williamtien23/monkeyV/doc/documentation.md

# riscv32i_w1
 <strong> Contents </strong> <br>
<ol>
  <li> Schematics </li>  
  <li> Compliance Tests </li>
  <li> The ALU Test </li>
  <li> The Sample C Program Test </li>
</ol>

<strong> Schematics </strong> <br><br>
IF_Stage: <br>
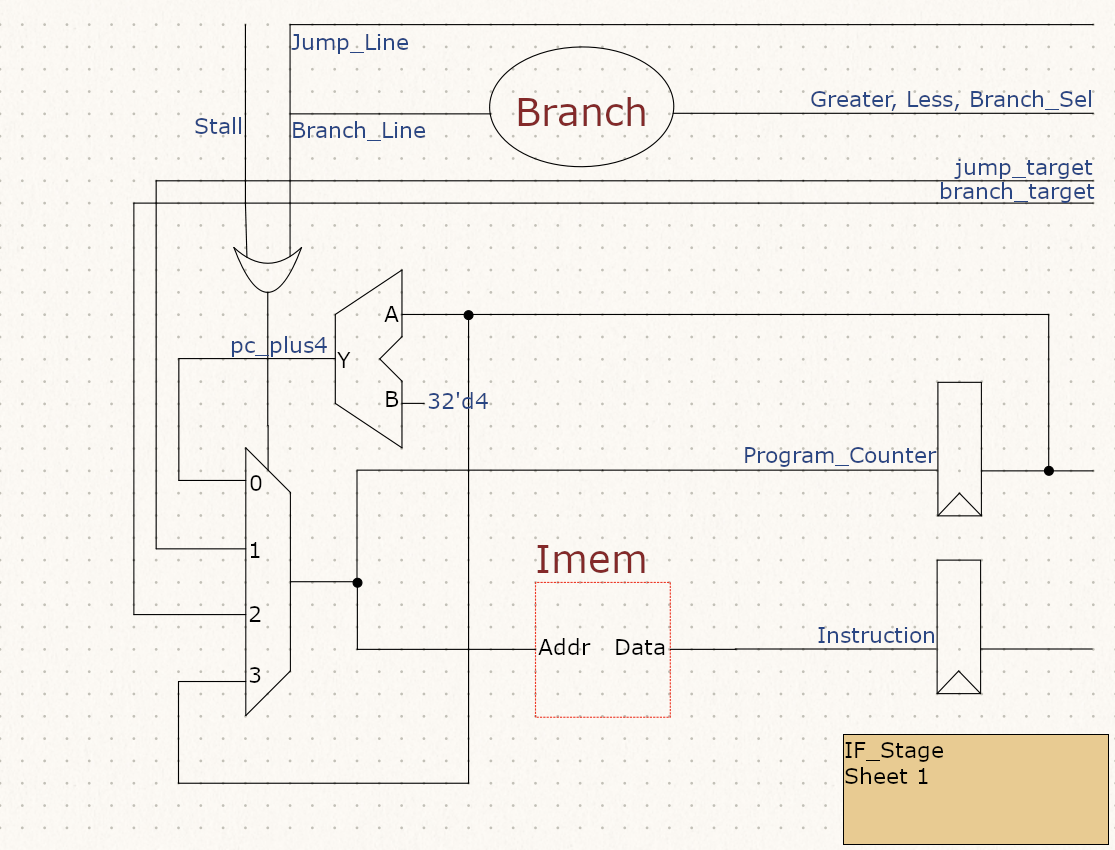
[picture p2: doc/IFStage.png]

<br><br><br>
ID_Stage: <br>
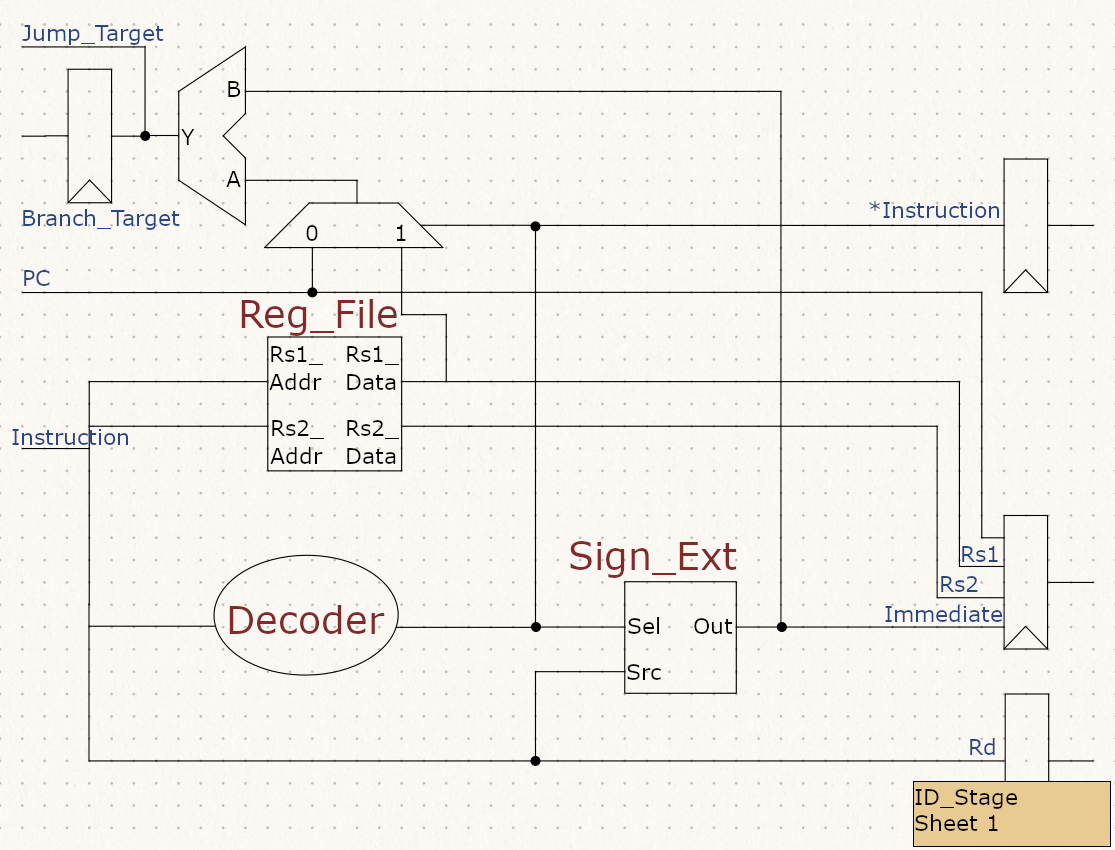
[picture p3: doc/ID_Stage.png]

<br><br><br>
EXE_Stage: <br>
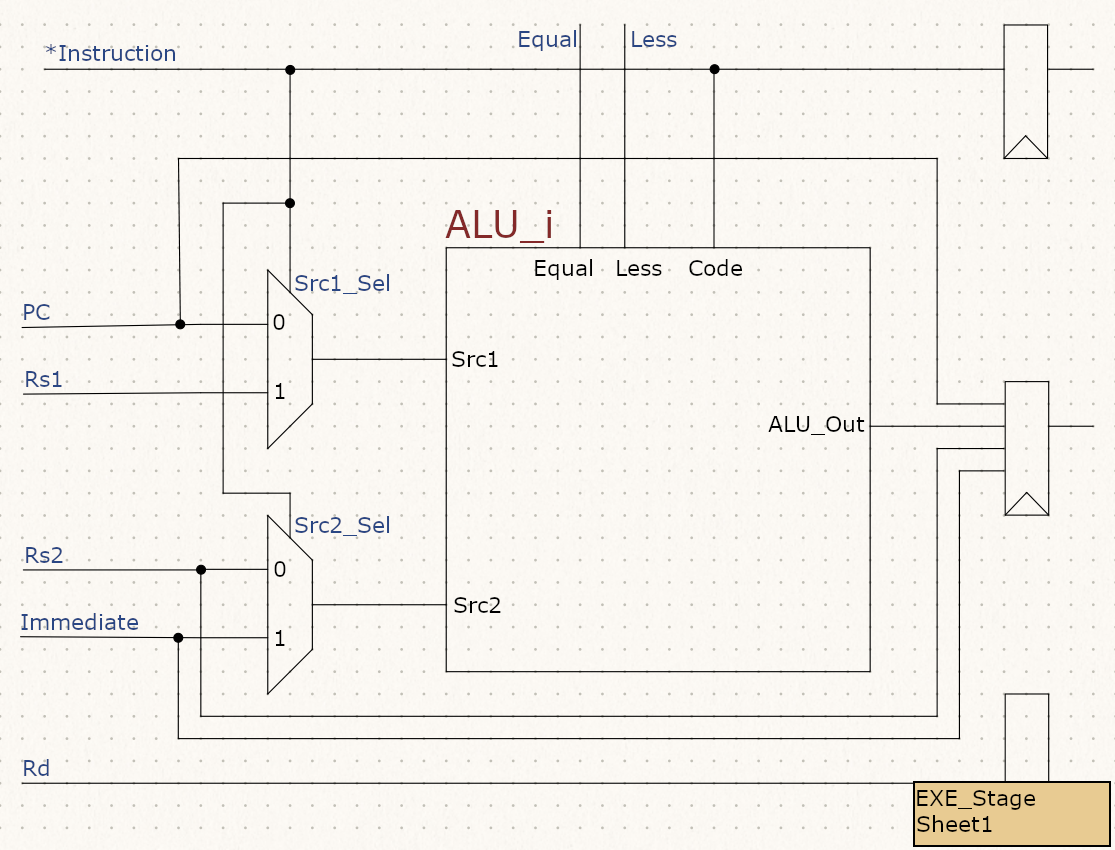
[picture p4: doc/ExeStage.png]

<br><br><br>
MEM_Stage: <br>
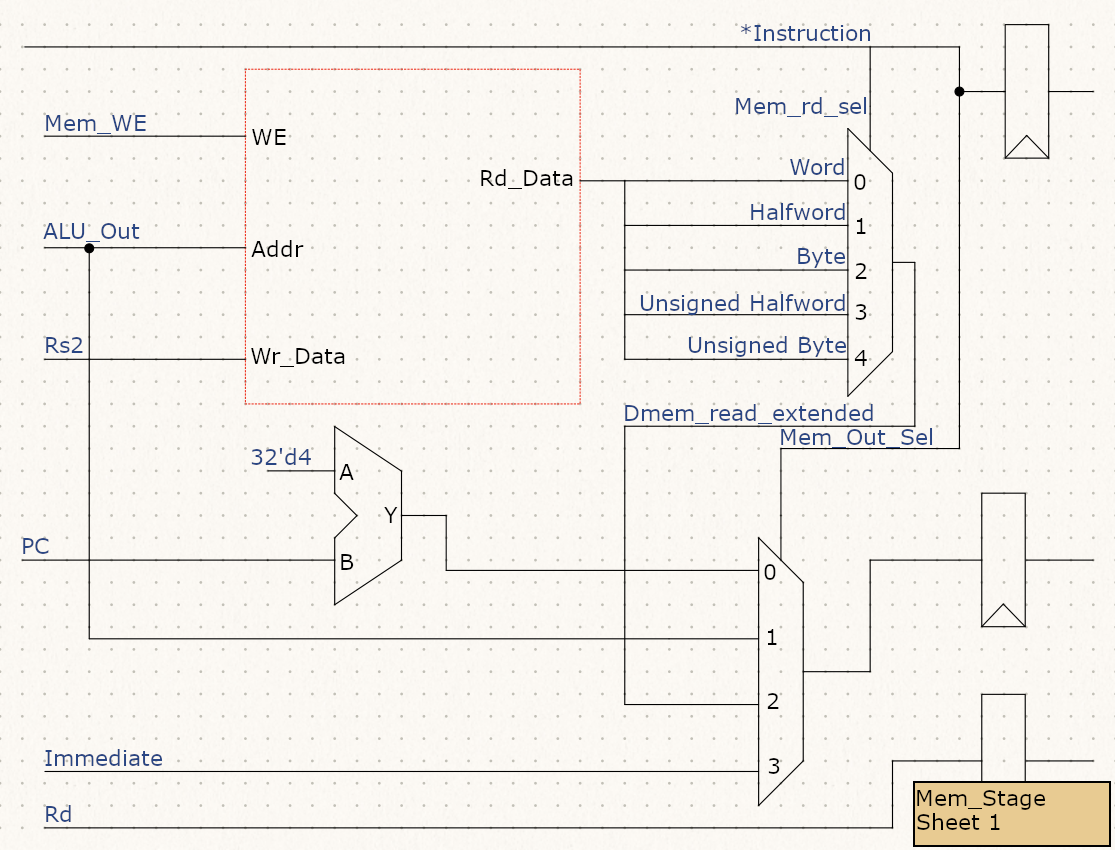
[picture p5: doc/MemStage.png]

<br><br><br>
ALU_i: <br>
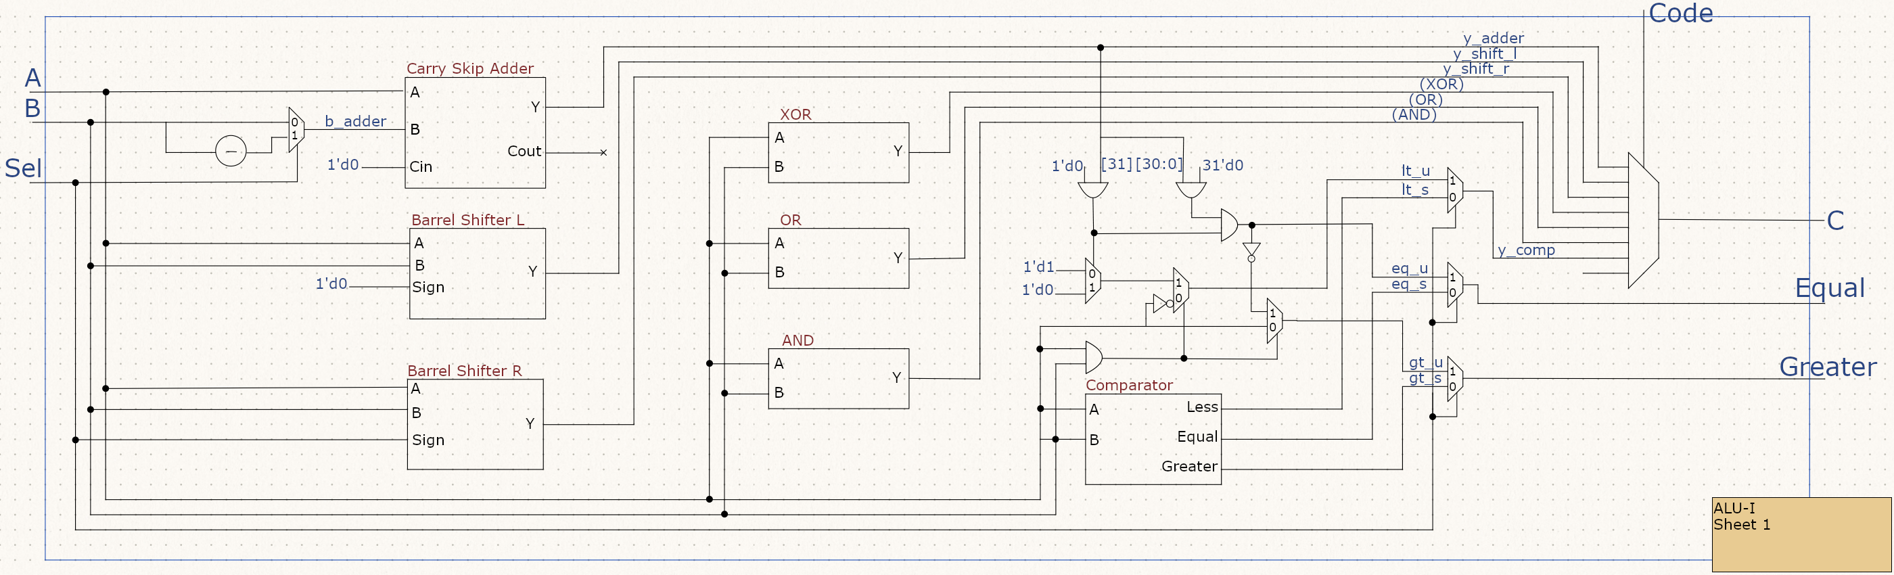
[picture p6: doc/ALU-I.png]

<br><br><br>
Carry_Select_Adder: <br>
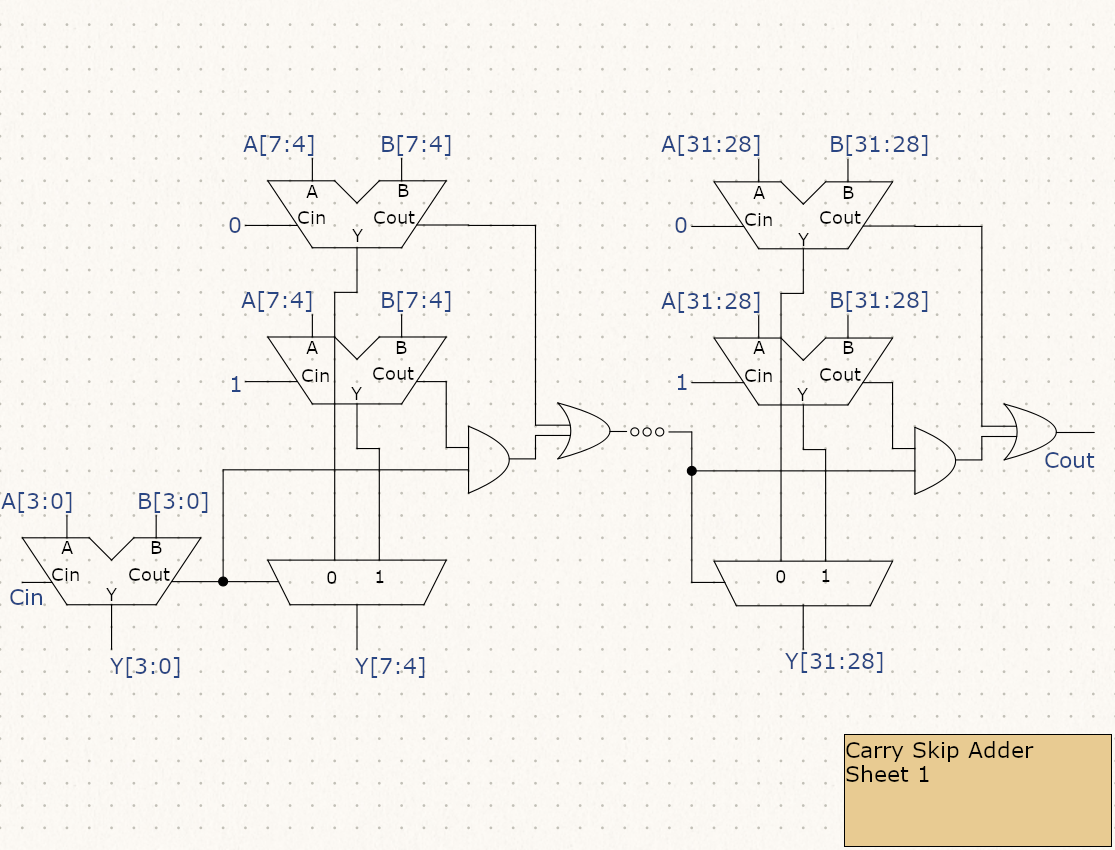
[picture p7: doc/CarrySelect_Adder.png]

<br><br><br>
Barrel_Shifters: <br>
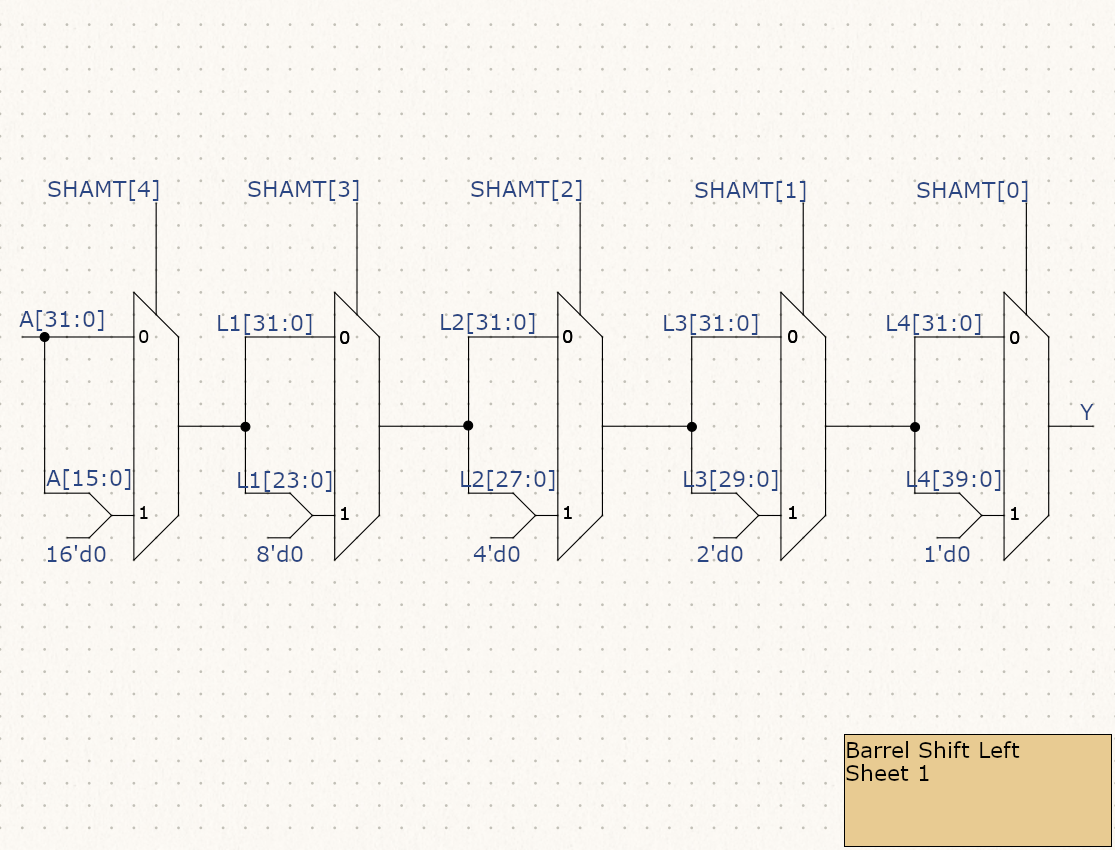
[picture p8: doc/BarrelShifter_Left.png]

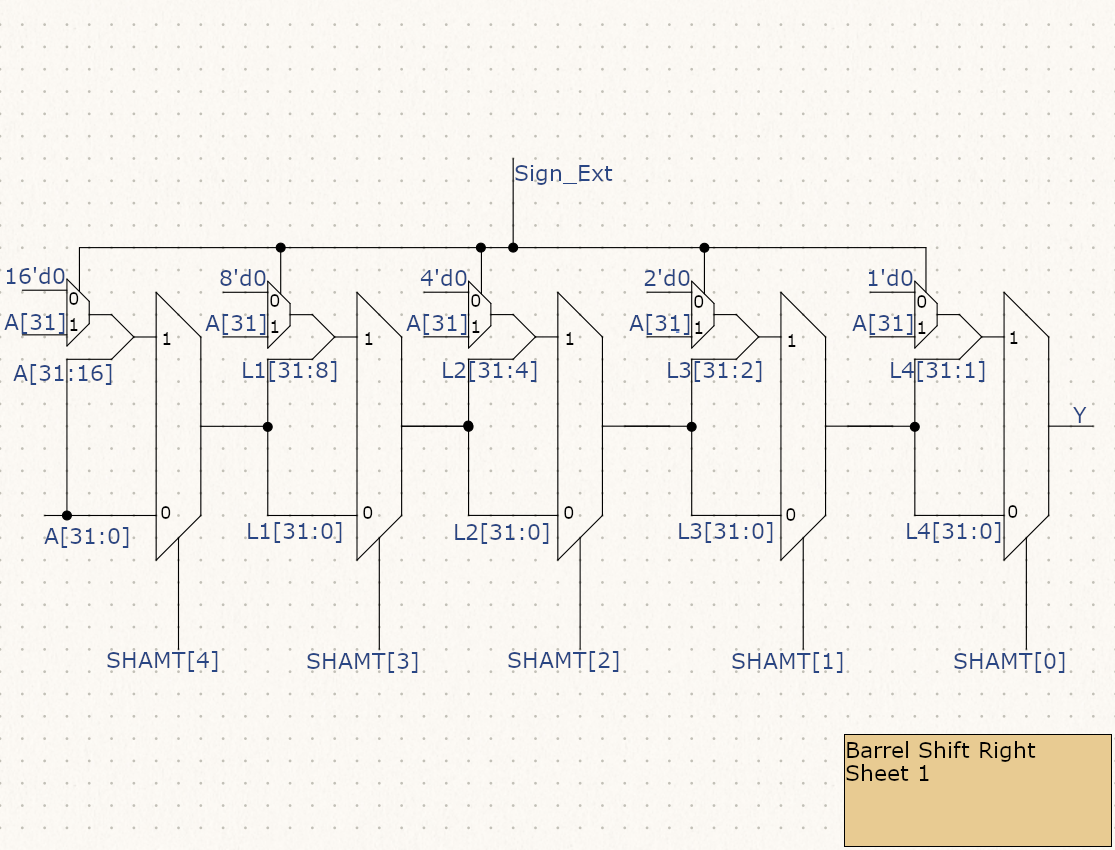
[picture p9: doc/BarrelShifter_Right.png]

<br><br><br>
Digital Comparator: <br>
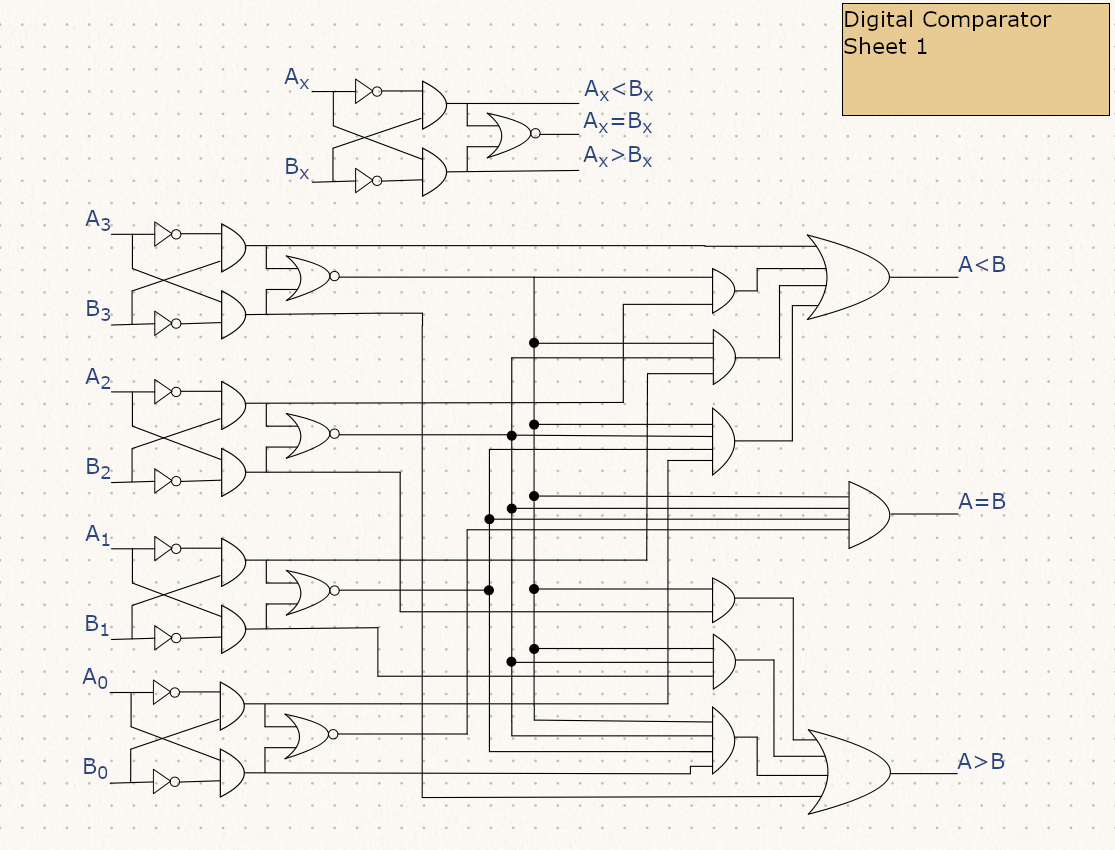
[picture p10: doc/Comparator_Sheet1.png]

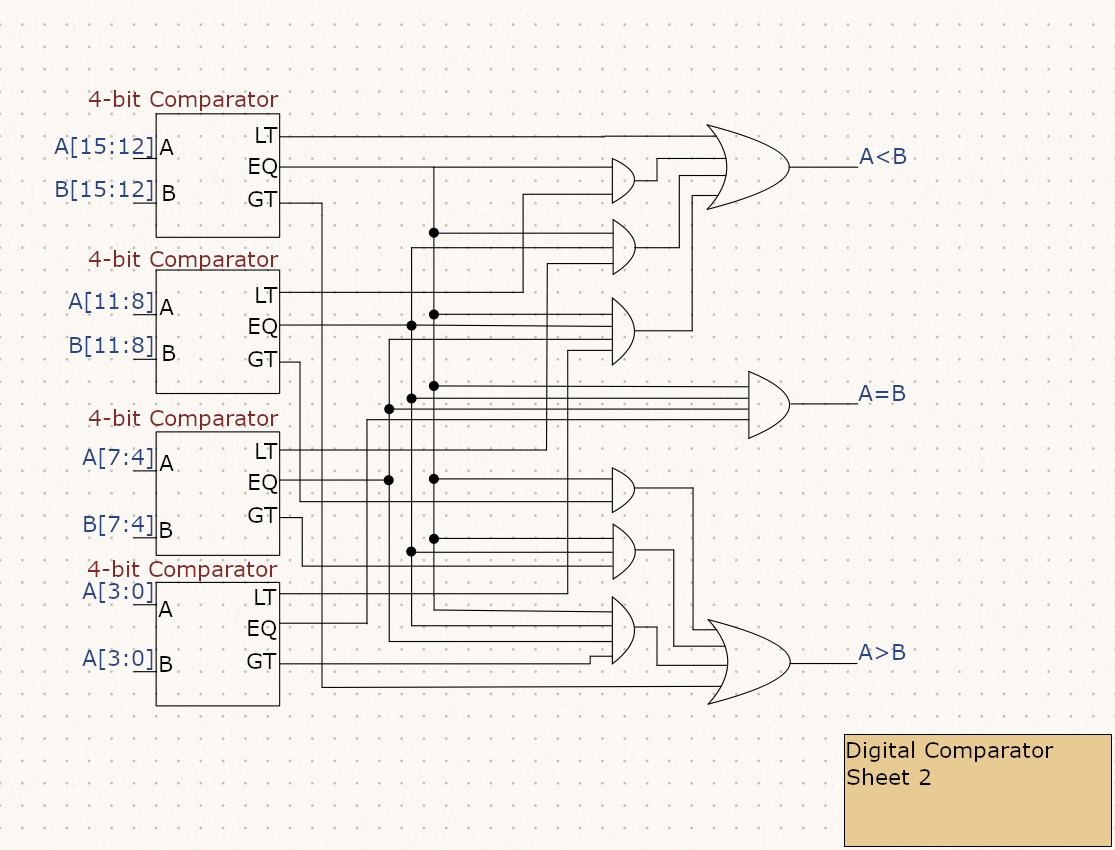
[picture p11: doc/Comparator_Sheet2.png]

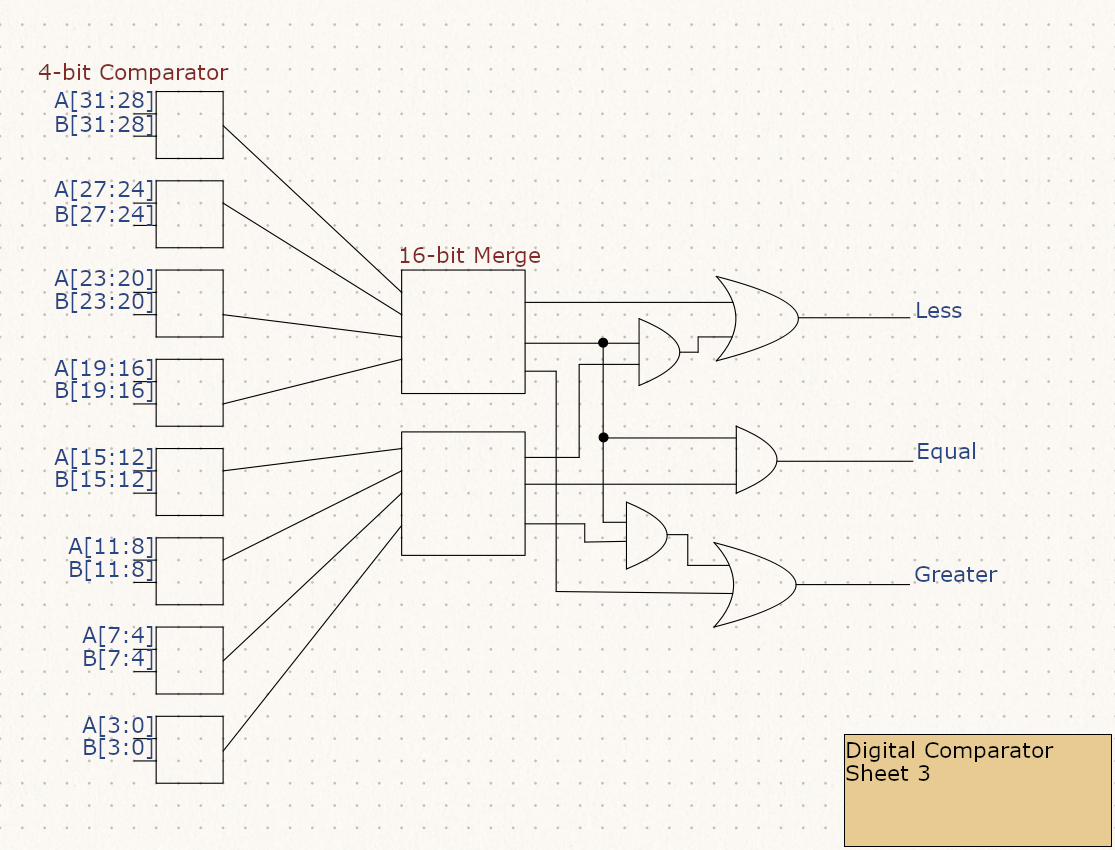
[picture p12: doc/Comparator_Sheet3.png]

<br><br><br>
Sign_Extender: <br>
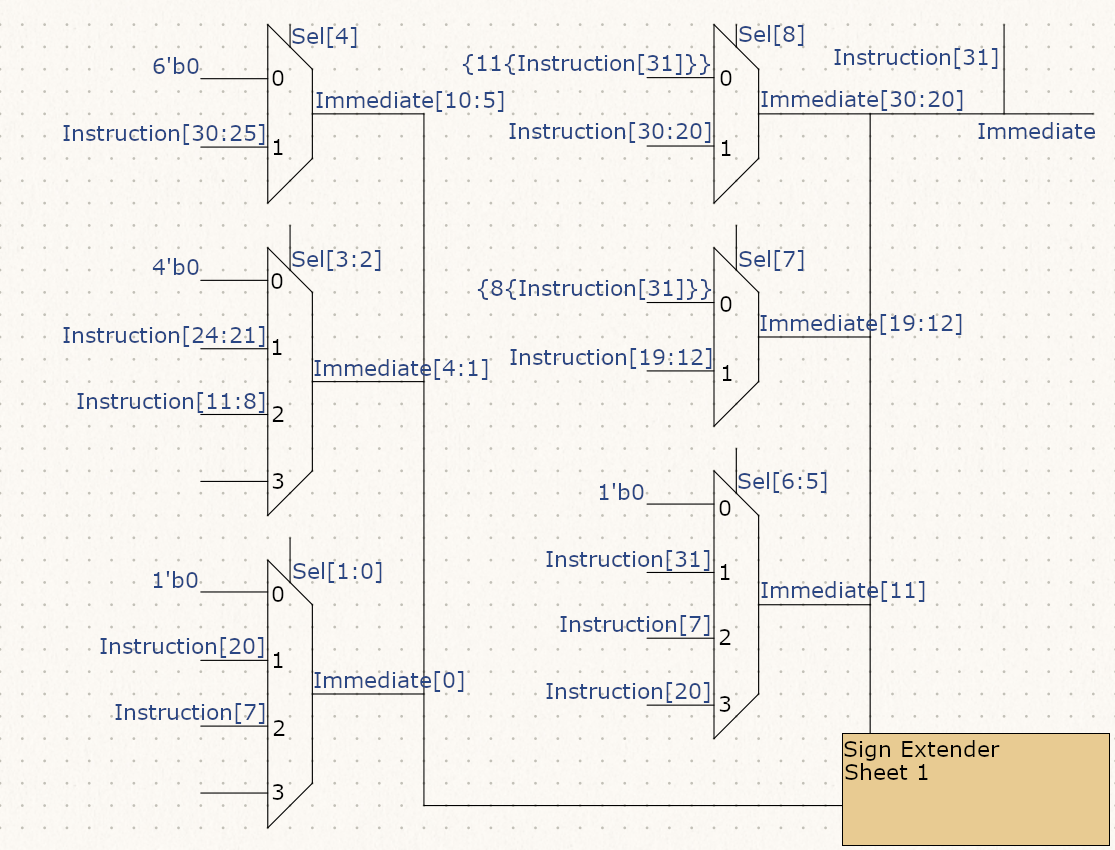
[picture p13: doc/SignExt.png]

<br><br><br>

<strong> Compliance Tests </strong> <br>
Running the automation bash script for the compliance tests generates the following results.
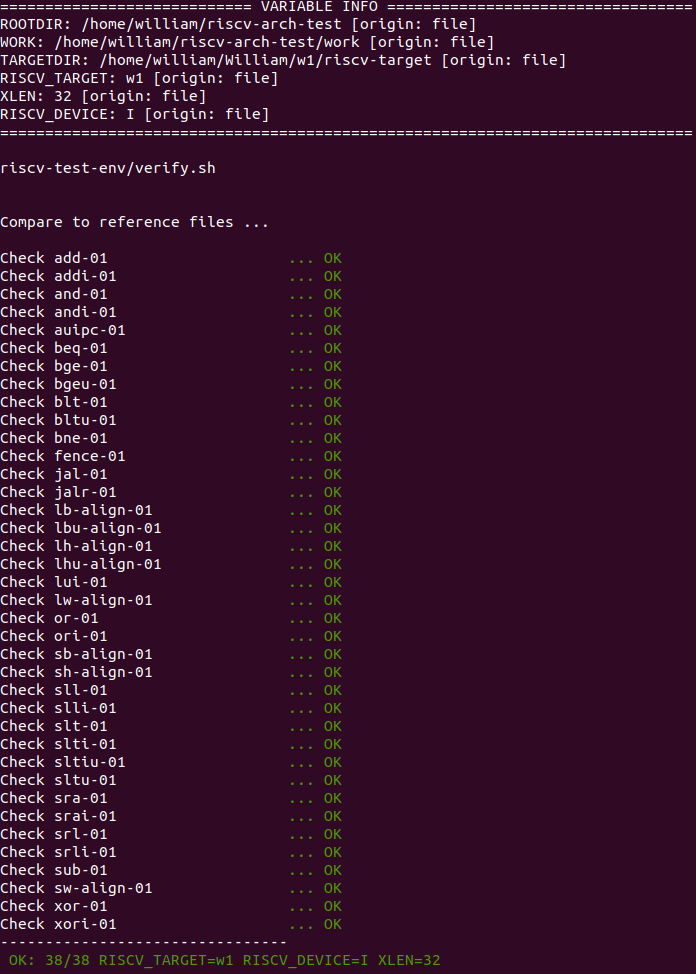
[picture p14: doc/compliance.png]


<strong> The ALU Test </strong> <br>
I tested the ALU by generating random signed int values in the cpp wrapper module. The cpp wrapper performs the same ALU operations alongside the simulated verilog ALU. Both answers are compared and the result is written as a Pass or Fail to the alu_tests.txt file that generates in /Testbenches. If a test case fails, the mismatched result from the verilog ALU is also outputted. An example:<br>
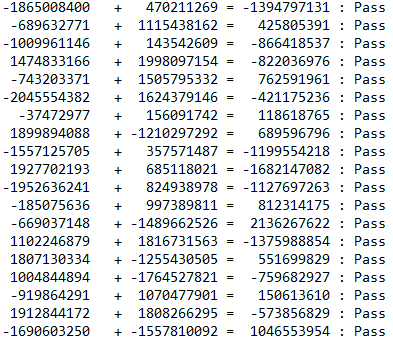
[picture p15: doc/alu_test_example.PNG]

<br>

<strong> The Sample C Program Test</strong> <br>
The following is the .text section of the ELF objdump from the example C program. Below are screenshots of the waveforms generated by running the C program on the core:<br>
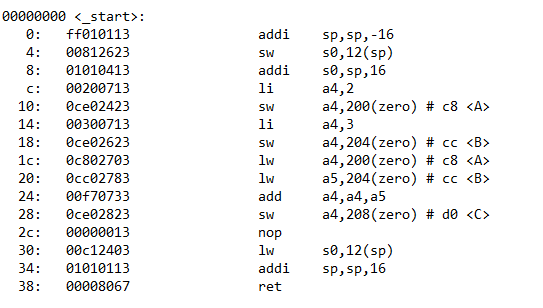
[picture p16: doc/objdump.PNG]

<br>

Program entry and first hazard:
<ol>
  <li> After reset, instruction fetch stage is fetches the first instruction "ff010113" which is latched and evaluated by instruction decode stage in the following cycle. </li>  
  <li> Data dependency on the sp register (x2) between the first instruction and the second instruction. The core stalls. </li>
  <li> Instruction decode stage can proceed only after the dependency has cleared the writeback stage. </li>
</ol>
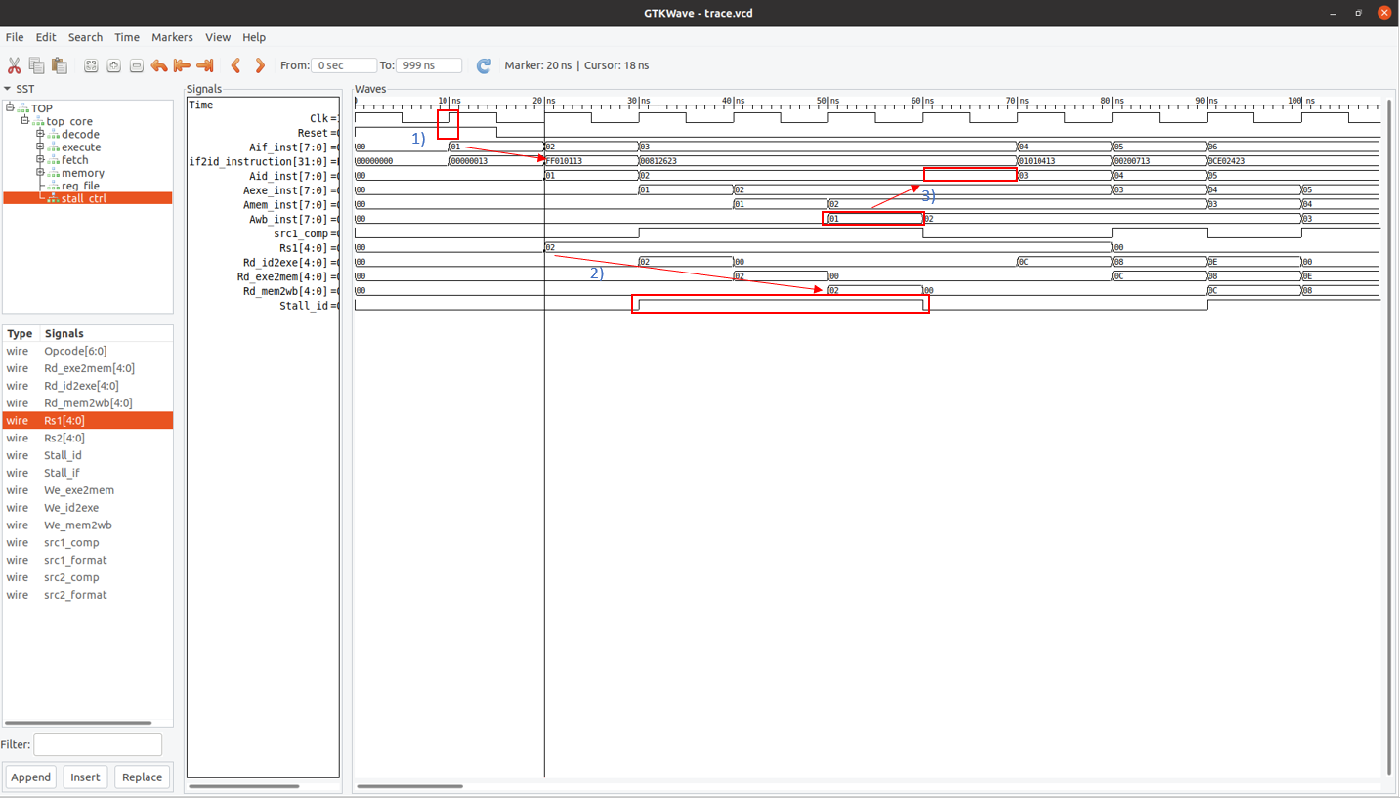
[picture p17: doc/sample_program_hazard.PNG]

<br>

A store instruction and hazard:
<ol>
  <li> Instruction fetch stage is fetching instruction 4 (PC at 0x8) followed by instruction 5 (PC at 0xC). </li>  
  <li> Instruction 5 has a dependency on instruction 4 over the a4 (x14) register. Instruction 4 must commit to write back stage before instruction 5 can proceed in the decode stage in the following cycle. Instruction 5 propogates 2 more cycles into the memory stage, and the correct memory address and write data appears in that cycle. </li>
</ol>
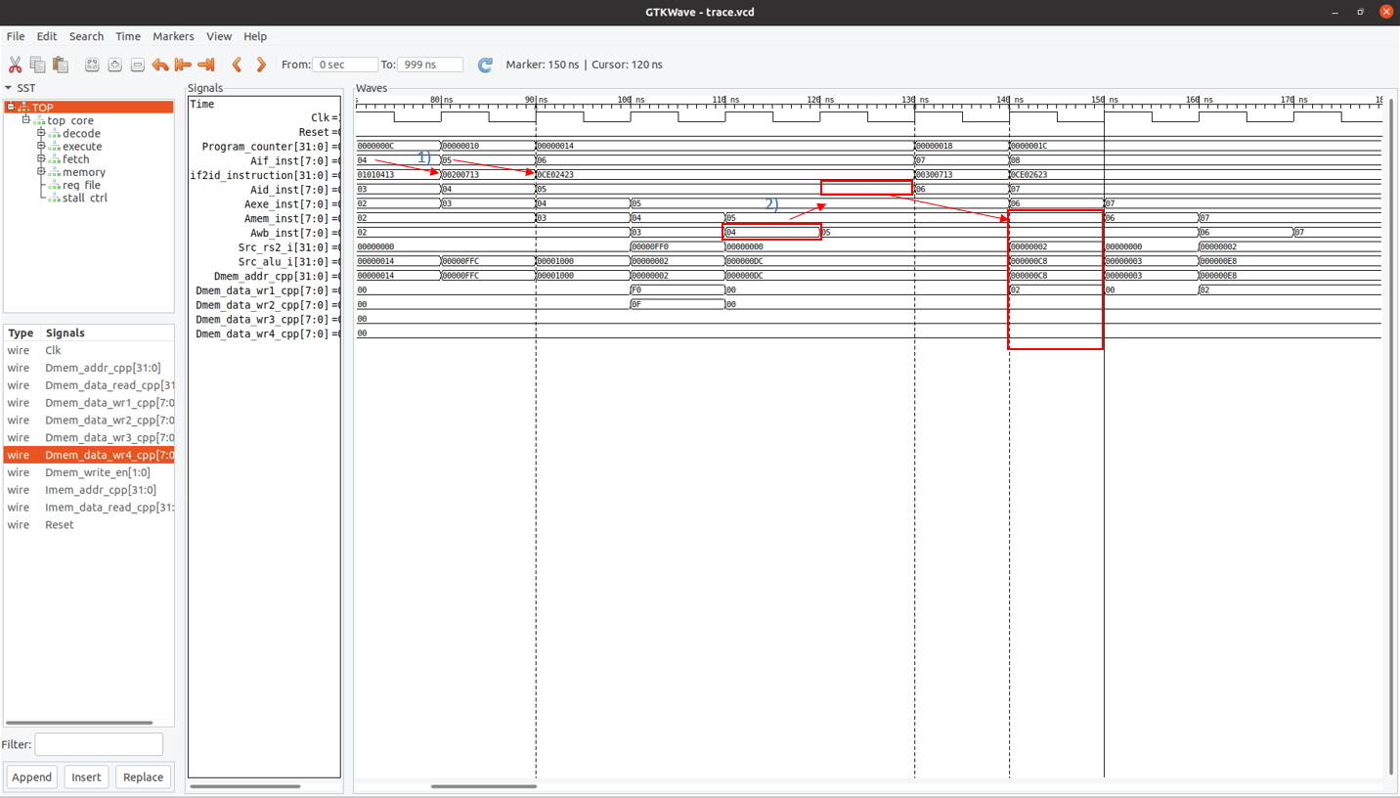
[picture p18: doc/sample_program_sw.PNG]

<br>

A load instruction:
<ol>
  <li> Load instruction "0CC02783" (PC at 0x20) is fetched and decoded. </li>  
  <li> Mem stage sets the correct Dmem address and the "memory" responds in same cycle with the result. </li>
  <li> Result loaded from memory is commited in the writeback stage and can be seen updated in the destination register in the following cycle. </li>
</ol>
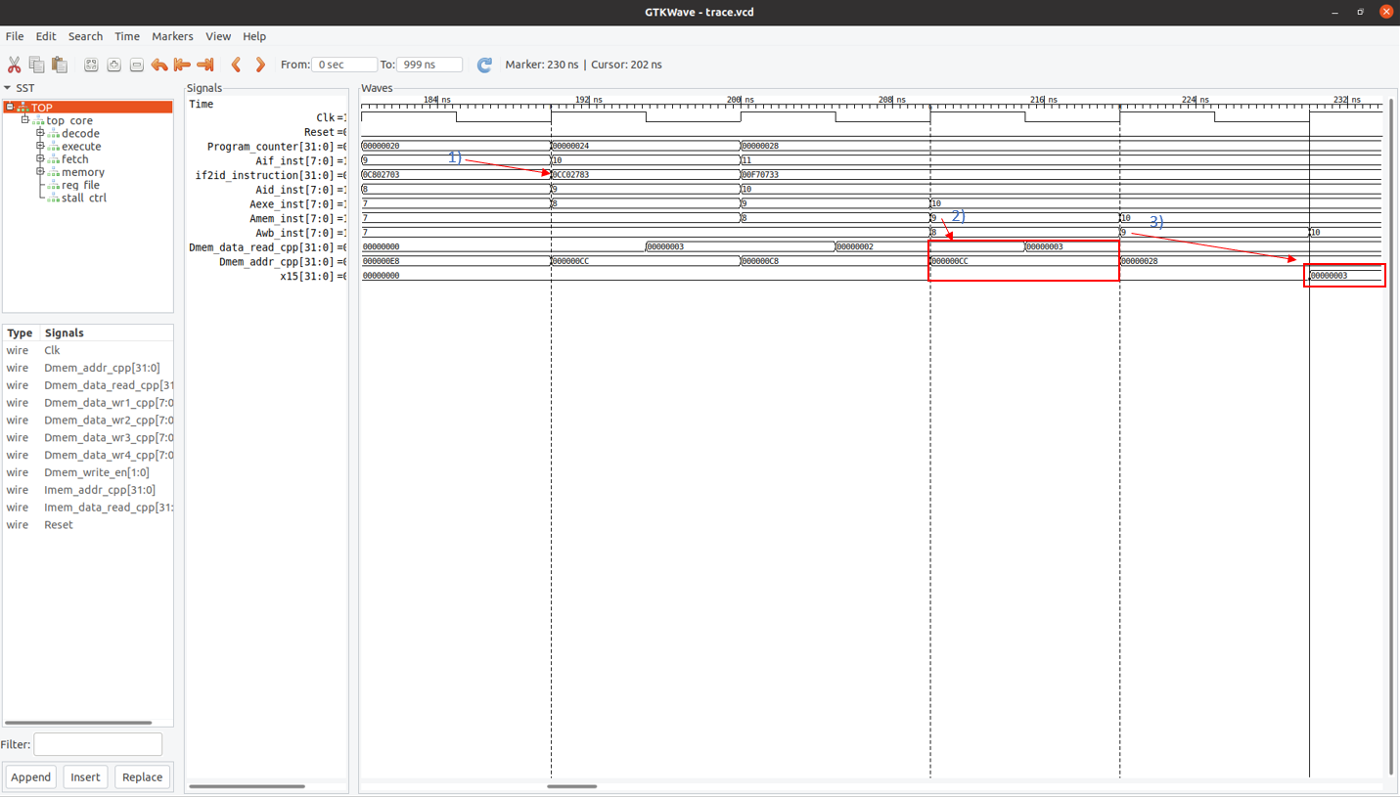
[picture p19: doc/sample_program_ld.PNG]

<br>

A jump instruction and program "exit":
<ol>
  <li> Final instruction at PC = 38 is fetched. </li>  
  <li> Decode stage recognizes a jump instruction, calculates the jump target and routes the PC source accordingly. A NOP injects into the decode stage as the fetch stage flushes and retrieves the next instruction. The jump target points back to the beginning of our program. </li>
</ol>
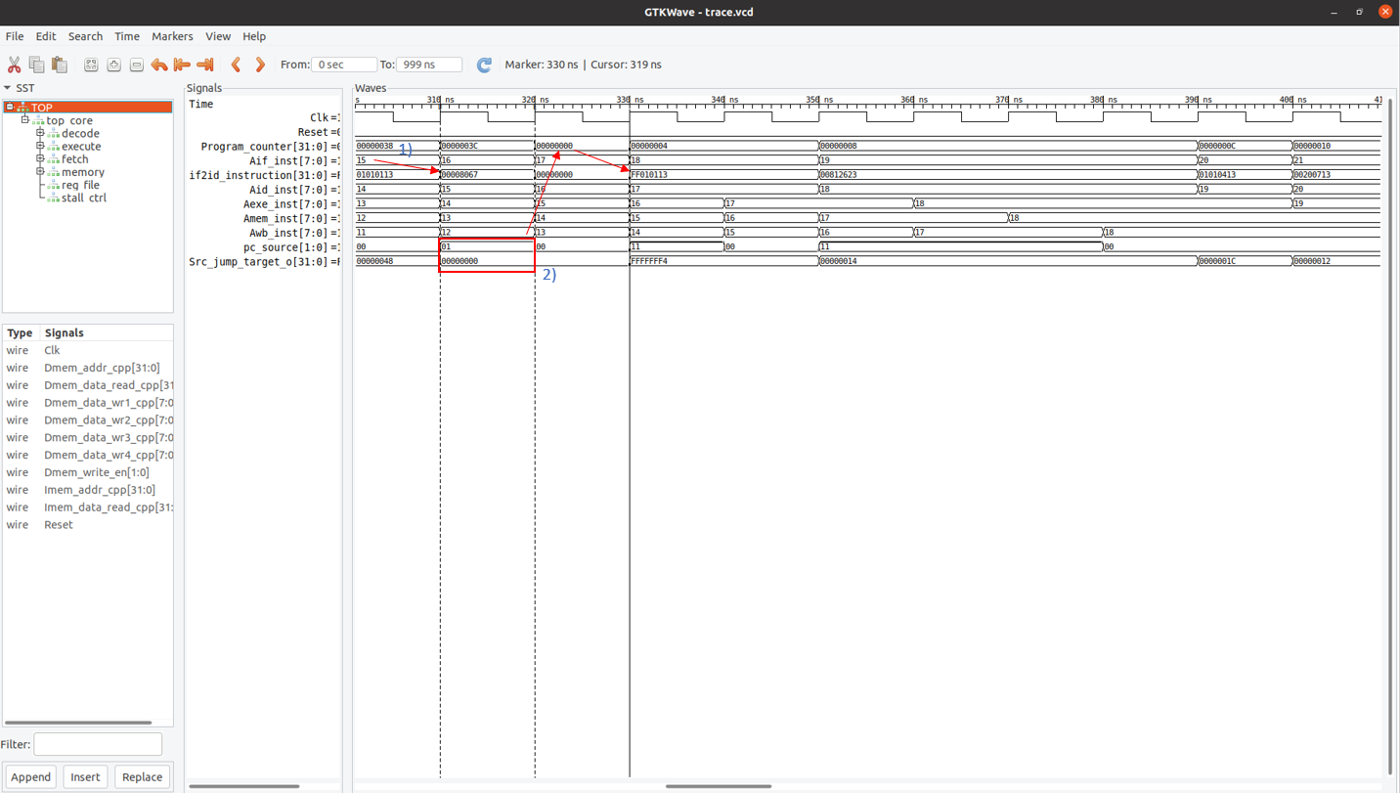
[picture p20: doc/sample_program_jalr.PNG]


The data memory following the execution of the program is exported to a text document which evaluates to the correct value of "C = A+B" that was ran in the program.
