williamtien23/monkeyV/Src_v/decoder.v

`include "defines.v"

module decoder (
  input [6:0] Opcode,
  input [2:0] Func3,
  input [6:0] Func7,
  output reg [2:0] Branch_sel,
  output reg       Jump_sel,
  output reg [4:0] Alu_code,
  output reg [1:0] Mem_we,
  output reg [2:0] Mem_rd_sel,
  output reg [1:0] Mem_out_sel,
  output reg       Wb_en,
  output reg [8:0] Imm_ext_sel,
  output Alu_src1_sel,
  output Alu_src2_sel
);

//Source Operand 1 Selection : Mux0->PC Mux1->Rs1
assign Alu_src1_sel = (Opcode==`OP_U_AUIPC) ? 0 : 1;

//Source Operand 2 Selection : Mux1->Rs2 Mux1->Immediate
assign Alu_src2_sel = (Opcode==`OP_R || Opcode==`OP_B) ? 0 : 1;  

//Sign Extension Encoding
always @ (*) begin
  case(Opcode)
    `OP_I_JALR, 
    `OP_I_LD, 
    `OP_I_ARITH : Imm_ext_sel = `FORMAT_I;
    `OP_S       : Imm_ext_sel = `FORMAT_S;
    `OP_B       : Imm_ext_sel = `FORMAT_B;
    `OP_U_LUI,
    `OP_U_AUIPC : Imm_ext_sel = `FORMAT_U;
    `OP_J       : Imm_ext_sel = `FORMAT_J;
    default     : Imm_ext_sel = `DEFAULT;
  endcase
end

//Instruction Decoding
always @ (*) begin
  if ((Opcode == `OP_R) && (Func3 == 3'b000) && (Func7 == 7'b0000000))begin //ADD
    Branch_sel   = `DEFAULT;
    Jump_sel     = `DEFAULT;
    Alu_code    = {`SEL_SIGNED, `ADD};
    Mem_we      = `WR_OFF;
    Mem_rd_sel  = `DEFAULT;
    Mem_out_sel = `MEM_ALU;
    Wb_en       = `WB_EN;
  end
  else if ((Opcode == `OP_R) && (Func3 == 3'b000) && (Func7 == 7'b0100000)) begin //SUB
    Branch_sel   = `DEFAULT;
    Jump_sel     = `DEFAULT;
    Alu_code    = {`SEL_NEG_B, `ADD};
    Mem_we      = `WR_OFF;
    Mem_rd_sel  = `DEFAULT;
    Mem_out_sel = `MEM_ALU;
    Wb_en       = `WB_EN;
  end
  else if ((Opcode == `OP_I_ARITH) && (Func3 == 3'b000)) begin //ADDI
    Branch_sel   = `DEFAULT;
    Jump_sel     = `DEFAULT;
    Alu_code    = {`SEL_SIGNED, `ADD};
    Mem_we      = `WR_OFF;
    Mem_rd_sel  = `DEFAULT;
    Mem_out_sel = `MEM_ALU;
    Wb_en       = `WB_EN;
  end
  else if ((Opcode == `OP_U_AUIPC)) begin //AUIPC
    Branch_sel   = `DEFAULT;
    Jump_sel     = `DEFAULT;
    Alu_code    = {`SEL_SIGNED, `ADD};
    Mem_we      = `WR_OFF;
    Mem_rd_sel  = `DEFAULT;
    Mem_out_sel = `MEM_ALU;
    Wb_en       = `WB_EN;
  end
  else if ((Opcode == `OP_S) && (Func3 == 3'b010)) begin //SW
    Branch_sel   = `DEFAULT;
    Jump_sel     = `DEFAULT;
    Alu_code    = {`SEL_SIGNED, `ADD};
    Mem_we      = `WR_WORD;
    Mem_rd_sel  = `DEFAULT;
    Mem_out_sel = `DEFAULT;
    Wb_en       = `WB_DISABLE;
  end
  else if ((Opcode == `OP_S) && (Func3 == 3'b001)) begin //SH
    Branch_sel   = `DEFAULT;
    Jump_sel     = `DEFAULT;
    Alu_code    = {`SEL_SIGNED, `ADD};
    Mem_we      = `WR_HWORD;
    Mem_rd_sel  = `DEFAULT;
    Mem_out_sel = `DEFAULT;
    Wb_en       = `WB_DISABLE;
  end
  else if ((Opcode == `OP_S) && (Func3 == 3'b000)) begin //SB
    Branch_sel   = `DEFAULT;
    Jump_sel     = `DEFAULT;
    Alu_code    = {`SEL_SIGNED, `ADD};
    Mem_we      = `WR_BYTE;
    Mem_rd_sel  = `DEFAULT;
    Mem_out_sel = `DEFAULT;
    Wb_en       = `WB_DISABLE;
  end
  else if ((Opcode == `OP_I_LD) && (Func3 == 3'b101)) begin //LHU
    Branch_sel   = `DEFAULT;
    Jump_sel     = `DEFAULT;
    Alu_code    = {`SEL_SIGNED, `ADD};
    Mem_we      = `WR_OFF;
    Mem_rd_sel  = `RD_HWORD_U;
    Mem_out_sel = `MEM_LD;
    Wb_en       = `WB_EN;
  end
  else if ((Opcode == `OP_I_LD) && (Func3 == 3'b100)) begin //LBU
    Branch_sel   = `DEFAULT;
    Jump_sel     = `DEFAULT;
    Alu_code    = {`SEL_SIGNED, `ADD};
    Mem_we      = `WR_OFF;
    Mem_rd_sel  = `RD_BYTE_U;
    Mem_out_sel = `MEM_LD;
    Wb_en       = `WB_EN;
  end
  else if ((Opcode == `OP_I_LD) && (Func3 == 3'b010)) begin //LW
    Branch_sel   = `DEFAULT;
    Jump_sel     = `DEFAULT;
    Alu_code    = {`SEL_SIGNED, `ADD};
    Mem_we      = `WR_OFF;
    Mem_rd_sel  = `DEFAULT;
    Mem_out_sel = `MEM_LD;
    Wb_en       = `WB_EN;
  end
  else if ((Opcode == `OP_I_LD) && (Func3 == 3'b001)) begin //LH
    Branch_sel   = `DEFAULT;
    Jump_sel     = `DEFAULT;
    Alu_code    = {`SEL_SIGNED, `ADD};
    Mem_we      = `WR_OFF;
    Mem_rd_sel  = `RD_HWORD;
    Mem_out_sel = `MEM_LD;
    Wb_en       = `WB_EN;
  end
  else if ((Opcode == `OP_I_LD) && (Func3 == 3'b000)) begin //LB
    Branch_sel   = `DEFAULT;
    Jump_sel     = `DEFAULT;
    Alu_code    = {`SEL_SIGNED, `ADD};
    Mem_we      = `WR_OFF;
    Mem_rd_sel  = `RD_BYTE;
    Mem_out_sel = `MEM_LD;
    Wb_en       = `WB_EN;
  end
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
    Wb_en       = `WB_EN;
  end
  else begin //Default
    Branch_sel   = `DEFAULT;
    Jump_sel     = `DEFAULT;
    Alu_code    = {`SEL_SIGNED, `ADD};
    Mem_we      = `WR_OFF;
    Mem_rd_sel  = `DEFAULT;
    Mem_out_sel = `MEM_ALU;
    Wb_en       = `WB_DISABLE;
  end
end
endmodule
